maxime-loiseau-labs/PIXELSAT-DIY/images/breadboard_proto.png

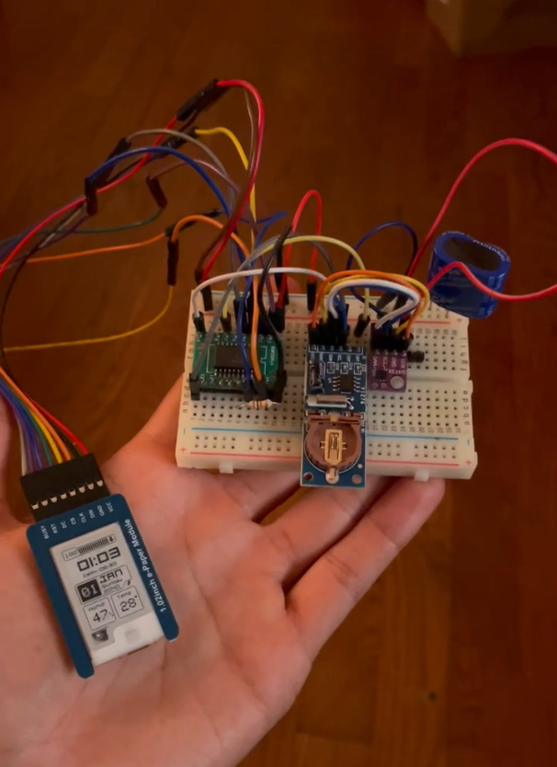
images/breadboard_proto.png
