maxime-loiseau-labs/PIXELSAT-DIY/images/rtc_drawing.png

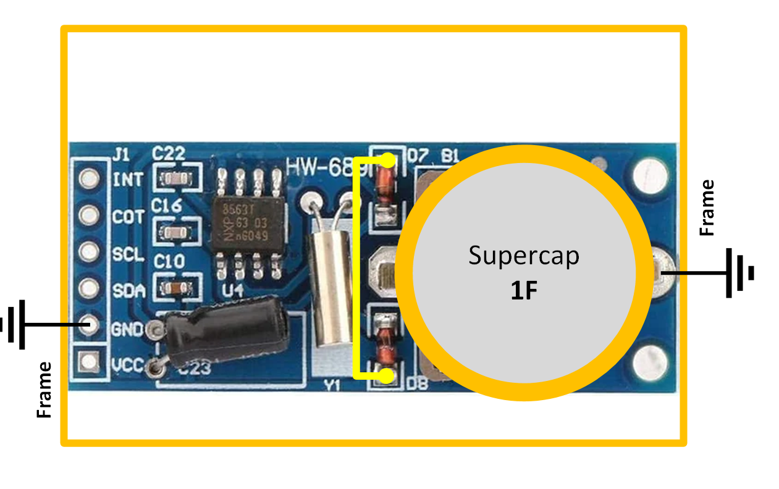
images/rtc_drawing.png
